tasogarenokagi/featherlight/README.md

LED medallion with 9-DOF motion sensing.
