tasogarenokagi/featherlight/featherlight.kicad_pcb

## KiCad design featherlight.kicad_pcb (2017-03-16)

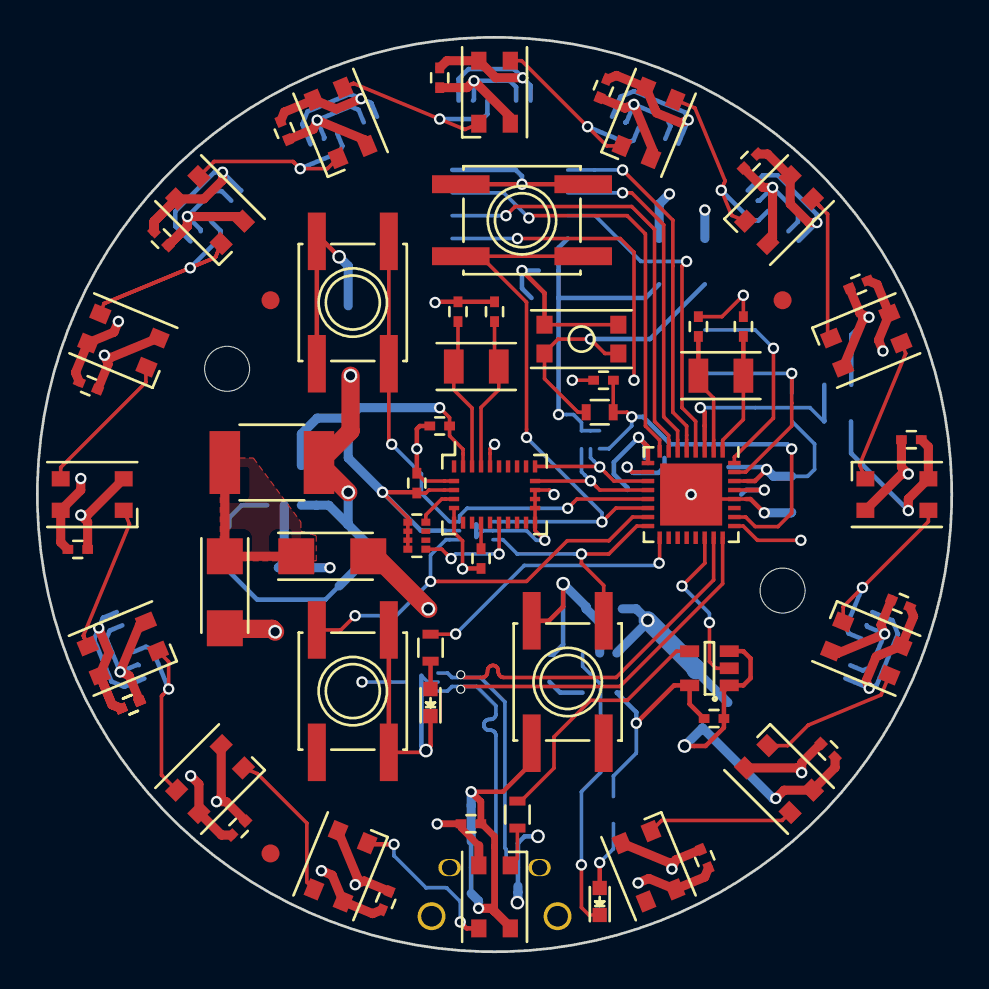
[picture p1: board featherlight.kicad_pcb from above]

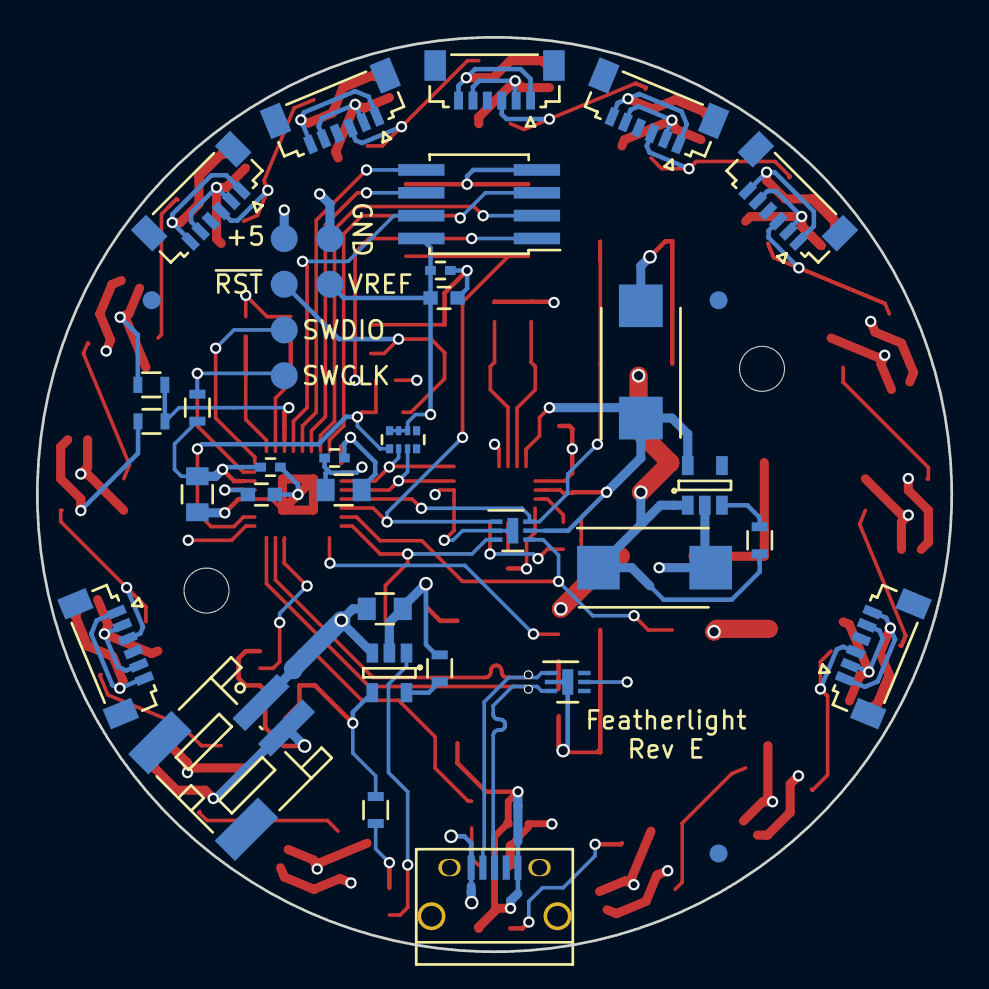
[picture p2: board featherlight.kicad_pcb from below]

Board: 4 copper layers, 50.8 x 50.8 mm, 106 parts (40 on the bottom side), 57 nets.

Parts:
C1, C2, C10, C11: 22 pF; C_0402
C3, C4, C7, C8, C9, C12, C13, C15, C16, C17, C18, C19, C20, C21, C22, C22#2, C23, C24, C25, C26, C27, C28, C29, C30, C35: 0.1 uF; C_0402
C5, C6, C33: 10 uF; C_0805
C14, C34: 1 uF; C_0603
C31, C32: 220 uF; TantalC_SizeD_EIA-7343_Reflow
D1, D2, D3, D4, D5, D6, D7, D8, D9, D10, D11, D12, D13, D14, D15, D16: SK6812MINI; LED_SK6812MINI-PLCC4
D19, D23: DRTR5V0U4LP16; DFN-6-1EP_2x2mm_Pitch0.5mm
D20, D24: MBRA210LT3G; DO-214AC
D21: Green; LED_0603
D22: Red; LED_0603
F1: FUSE; 1812_PTC
FID1, FID2, FID3, FID4, FID5, FID6: Fiducial; Fiducial_1mm_Dia_2.54mm_Outer_CopperTop
HOLE1, HOLE2: Fiducial; MountingHole_2.5mm
P1: USB_OTG; USB_Micro-B
P2: CONN_01X02; JST_PH_S2B-PH-SM4-TB_02x2.00mm_Angled
P3, P4, P5, P6, P7, P8: CONN_01X01; Measurement_Point_Round-SMD-Pad_Small
P11, P12, P13, P14, P15, P16, P17: CONN_01X06; JST_SUR_SM06B-SURS-TF_06x0.80mm_Angled
R2, R7, R12: 470; R_0603
R3, R4: 1 K; R_0603
R10, R11, R13: 100 K; R_0603
R14: 10 K; R_0603
RN1, RN2: 10 K; R_Array_Convex_4x0402
SW1: Button; KMR2_switch
SW2, SW3, SW4, SW5: Button; SW_SPST_EVQQ2
U1: BNO055; LGA-28
U2: SAMD21E18A-M; QFN-32-1EP_5x5mm_Pitch0.5mm
U3: 74AHCT1G125; SOT-23-5
U4: AP2112; SOT-23-5
U5: MCP73831; SOT-23-5
U6: 16 Mb SPI Flash; SOIC-8_Universal_Pitch1.27mm
Y1, Y2: 32.768 KHz; Crystal_SMD_3215_2Pads

Connections:
+3V3: C3.1, C4.2, C5.1, C6.2, C7.1, C8.2, C32.1, C34.1, C35.1, D23.5, P8.1, R4.1, RN1.6, RN1.7, RN1.8, RN2.1, RN2.2, RN2.3, RN2.4, U1.3, U1.28, U2.9, U2.30, U4.5, U6.8
+BATT: C33.2, D20.2, P2.1, U5.3
/LED Array/D1D0: D1.1, D2.3
/LED Array/D2DO: D2.1, D3.3
/LED Array/D3DO: D3.1, D4.3, P11.3
/LED Array/D4DO: D4.1, D5.3
/LED Array/D5DO: D5.1, D6.3
/LED Array/D6DO: D6.1, D7.3, P12.3
/LED Array/D7DO: D7.1, D8.3, P13.3
/LED Array/D8DO: D8.1, D9.3, P14.3
/LED Array/D9DO: D9.1, D10.3, P15.3
/LED Array/D10DO: D10.1, D11.3, P16.3
/LED Array/D11DO: D11.1, D12.3
/LED Array/D13DO: D13.1, D14.3, P17.3
/LED Array/D14DO: D14.1, D15.3
/LED Array/D15DO: D15.1, D16.3
/MCU + IMU/ATMEL_RESET: C9.1, R2.1, RN1.1, U2.26
/MCU + IMU/BNO_BOOTLOAD: RN2.8, U1.4
/MCU + IMU/BNO_RESET: RN2.5, U1.11
/MCU + IMU/LV_LED_control_stream: U2.22, U3.2
/MCU + IMU/MISO: U2.7, U6.2
/MCU + IMU/MOSI: U2.5, U6.5
/MCU + IMU/SCL: RN1.3, U1.19, U2.12
/MCU + IMU/SCLK: U2.6, U6.6
/MCU + IMU/SDA: RN1.2, U1.20, U2.11
/MCU + IMU/~CS~: U2.25, U6.1
/MCU + IMU/~HOLD~: U2.4, U6.7
/MCU + IMU/~WP~: U2.8, U6.3
/Power Regulation & Distribution/VFUSE: D20.1, D24.1, F1.1
/Power Regulation & Distribution/VUSB: D19.5, D24.2, P1.1
D+: D19.3, P1.3, U2.24
D-: D19.1, P1.2, U2.23
GND: C1.1, C2.1, C3.2, C4.1, C5.2, C6.1, C7.2, C8.1, C9.2, C10.1, C11.1, C12.2, C13.2, C14.2, C15.2, C16.2, C17.2, C18.2, C19.2, C20.2, C21.2, C22.2, C22#2.2, C23.2, C24.2, C25.2, C26.2, C27.2, C28.2, C29.2, C30.2, C31.2, C32.2, C33.1, C34.2, C35.2, D1.2, D2.2, D3.2, D4.2, D5.2, D6.2, D7.2, D8.2, D9.2, D10.2, D11.2, D12.2, D13.2, D14.2, D15.2, D16.2, D19.2, D19.7, D22.1, D23.2, D23.7, P1.5, P1.6, P2.2, P7.1, P11.1, P11.6, P12.1, P12.6, P13.1, P13.6, P14.1, P14.6, P15.1, P15.6, P16.1, P16.6, P17.1, P17.6, R13.1, R14.2, SW1.1, SW2.1, SW3.1, SW4.1, SW5.1, U1.2, U1.5, U1.6, U1.15, U1.16, U1.17, U1.18, U1.25, U2.10, U2.28, U2.33, U3.1, U3.3, U4.2, U5.2, U6.4
LED_control_stream: R7.2, U3.4
LL_BUTTON: D23.4, SW4.2, U2.15
LR_BUTTON: D23.3, SW5.2, U2.16
unnamed: C1.2, U2.1, Y1.1
unnamed: C2.2, U2.2, Y1.2
unnamed: C10.2, U1.26, Y2.1
unnamed: C11.2, U1.27, Y2.2
unnamed: C12.1, U1.9
unnamed: C14.1, U2.29
unnamed: D1.3, R7.1
unnamed: D12.1, D13.3
unnamed: D21.1, U5.1
unnamed: D21.2, R12.2
unnamed: D22.2, R3.1
unnamed: R3.2, U2.17
unnamed: R10.1, U4.3
unnamed: R14.1, U5.5
SWCLK: P3.1, R4.2, U2.31
SWDIO: P4.1, U2.32
UL_BUTTON: D23.6, SW2.2, U2.13
UR_BUTTON: D23.1, SW3.2, U2.14
VDD: C13.1, C15.1, C16.1, C17.1, C18.1, C19.1, C20.1, C21.1, C22.1, C22#2.1, C23.1, C24.1, C25.1, C26.1, C27.1, C28.1, C29.1, C30.1, C31.1, D1.4, D2.4, D3.4, D4.4, D5.4, D6.4, D7.4, D8.4, D9.4, D10.4, D11.4, D12.4, D13.4, D14.4, D15.4, D16.4, F1.2, P6.1, P11.2, P11.5, P12.2, P12.5, P13.2, P13.5, P14.2, P14.5, P15.2, P15.5, P16.2, P16.5, P17.2, P17.5, R10.2, R11.2, R12.1, U3.5, U4.1, U5.4
VDD_MON: R11.1, R13.2, U2.3
~RST~: P5.1, R2.2, SW1.2
