tasogarenokagi/featherlight/(commit log)

2016-08-26 initial file import
    [featherlight.kicad_pcb, featherlight.sch, featherlight_mcu.sch, leds.sch, power.sch]
2016-08-30 Added part BOM metadata.
    [featherlight.kicad_pcb, featherlight_mcu.sch, leds.sch, power.sch]
2016-09-02 Component changes to reduce BOM cost.
    -Swap SAMD21 package to 48-QFN.
    -Swap Tantalum power caps for Aluminum Polymer.
    [featherlight.kicad_pcb, featherlight_mcu.sch, power.sch]
2016-09-04 Prepare for github export.
    -Added README.md
    -Added LICENSE.md
    -Exported footprints.
2016-09-08 Further development work while waiting for the first prototypes to come back.
    -Moved to 4 layer board because the power routing got to be too much of a headache.
    -Run all power through a PTC fuse.
    -Added a voltage divider to allow the MCU to monitor bus voltage.
    -Added JST-2 connector and battery circuitry to permit powering from lipo cells. Feeds VDD via a diode to avoid bad things happening. Intended to work with Adafruit's packs.
    -Added 4 push buttons to form a user interface.
    -Removed external pull up resistor on reset line. MCU has internal pull ups.
    [featherlight.kicad_pcb, featherlight_mcu.sch, leds.sch, power.sch]
2016-09-08 Propagate component MSL data back from BOM spreadsheet.
    [featherlight_mcu.sch, leds.sch, power.sch]
2016-09-08 Tweaked trace routing to remove several vias.
    Expanded the copper pour connecting 3.3V regulator to power plane.
    Removed placeholder MDBT40 footprint. I want to see if the buttons are enough of a UI that bluetooth is no longer necessary.
    [featherlight.kicad_pcb]
2016-09-09 Changed PTH on the USB footprint to circular drills since Oshpark cannot into slots.
    [featherlight.kicad_pcb, power.sch]
2016-09-11 Improper board size required full PCB redesign.
    The rev A PCBs were far bigger than intended (target diameter was used as radius when laying it out).
    Removed lipo circuit while reworking layout; will try to add it back in later.
    Moved USB port to very edge of board to permit cable access.
    Added +5V and ground contacts to ISP pads.
    Swapped down to SAMD21E MCU for space reasons.
    Removed connectors for space reasons. Maybe they'll fit on the bottom?
    Added fiducials front and back.
    [featherlight.kicad_pcb, featherlight.sch, featherlight_mcu.sch, leds.sch, power.sch]
2016-09-11 Linked appropriate or placeholder 3D models to custom footprints.
2016-09-11 Re-added lipo circuit.
    [featherlight.kicad_pcb, featherlight_mcu.sch, power.sch]
2016-09-11 Trying out a 2 inch diameter disk.
    [featherlight.kicad_pcb]
2016-09-12 Added MCU reset to SWD pads.
    [featherlight.kicad_pcb, featherlight_mcu.sch, power.sch]
2016-09-13 I have greatly misunderstood the function of VDDCore on the MCU. orz.
    Added additional bypass caps for the MCU and changed the battery bypass cap for BOM commonality.
    [featherlight.kicad_pcb, featherlight_mcu.sch, leds.sch, power.sch]
2016-09-13 Reenumerated all components.
    [featherlight.kicad_pcb, featherlight.sch, featherlight_mcu.sch, leds.sch, power.sch]
2016-09-14 Added mounting holes and two candidates for fingerlight connectors.
    [featherlight.kicad_pcb, featherlight_mcu.sch, leds.sch, power.sch]
2016-09-15 Swapped UI buttons to EVQQ2 and rearranged board to fit.
    [featherlight.kicad_pcb, featherlight_mcu.sch]
2016-09-15 Always run DRC before commiting.
    [featherlight.kicad_pcb]
2016-09-16 Dimensioned PCB and location of mounting holes.
    [featherlight.kicad_pcb]
2016-09-16 Redid dimensioning after trying to create a mechanical model.
    [featherlight.kicad_pcb]
2016-09-18 cleaned up VUSB trace on the back layer.
    [featherlight.kicad_pcb]
2016-09-19 Swapped BOM fields on UI buttons to Panasonic EVQQ2 switches.
    [featherlight_mcu.sch]
2016-09-19 Moved 2nd resistor in VDD voltage divider to top layer because I can and it deletes a via.
    [featherlight.kicad_pcb]
2016-09-27 Added USB plated through holes to paste layers.
    [featherlight.kicad_pcb]
2016-10-06 Rerouted serpentine ground trace on neopixel #1
    [featherlight.kicad_pcb]
2016-10-06 Bumped revision to rev C.
    [featherlight.kicad_pcb]
2016-10-09 10000 pF is not 0.1 uF. Fixed all the screwed up caps.
    [featherlight.sch, featherlight_mcu.sch, leds.sch]
2016-11-25 Remove uneeded track found during gerber review.
    [featherlight.kicad_pcb]
2016-11-25 Adjusted micro USB footprint so the PTH are not on the front paste layer.
    [featherlight.kicad_pcb]
2016-11-26 Reduced solder paste ratio to try and address solder bridging issues.
    [featherlight.kicad_pcb]
2016-11-27 Critical failure: EP on SAMD21 is tied to ground. orz.
    [featherlight.kicad_pcb, featherlight.sch, featherlight_mcu.sch, leds.sch, power.sch]
2016-11-27 Addressed several todo items while working towards rev C tape out.
    *Tweaked fill zone settings.
    *Tweaked design rules to permit use of a faster PCB house.
    *Removed FFC connectors since they were found wanting vs the JST SUR connectors.
    *Replaced cluster of 10 K resistors with a packed array.
    [featherlight.kicad_pcb, featherlight_mcu.sch, leds.sch, power.sch]
2016-11-28 Addressed several todo items while working towards rev C tape out.
    *Added additional fingerlight connectors to make the design ambidextrous.
    *Moved programming pads and added a 3.3V Vref pad.
    *Added a SPI flash chip because micropython might be cool.
    *Added ESD protection to the UI buttons and adjusted schematic to allow use of a different component.
    *Added isolation diode on Vusb, and moved Vusb trace to internal layer.
    [featherlight.kicad_pcb, featherlight_mcu.sch, leds.sch, power.sch]
2016-11-28 Trace cleanup noticed while reviewing gerbers.
    [featherlight.kicad_pcb]
2016-12-10 Somehow I deleted the mounting holes while working on rev C.
    Had to move UL button and VDD power LED to add them back in at a new position.
    [featherlight.kicad_pcb]
2016-12-10 Bumped to rev D.
    [featherlight.kicad_pcb]
2016-12-11 Added stencil supports to Eco layers and re-dimensioned the mounting holes.
    [featherlight.kicad_pcb]
2016-12-18 Rescaled power diode 3D models, and adjusted support pillar after jig fabrication issues.
    [featherlight.kicad_pcb]
2016-12-23 Adjusted support pillar after jig fabrication issues.
    [featherlight.kicad_pcb]
2017-01-03 Removed trace bodge on USB ESD protection. A solder bridge will work for the few remaining components.
    [featherlight.kicad_pcb, power.sch]
2017-01-03 Deleted power rail LEDs.
    [featherlight.kicad_pcb, power.sch]
2017-01-03 Discovered why the mounting holes keep disappearing, so they're on the schematic now.
    [featherlight.kicad_pcb, featherlight.sch]
2017-01-03 Replaced SOIC-8 footprint with one that can accomodate both 3.9mm and 5.3mm component widths.
    [featherlight.kicad_pcb, featherlight_mcu.sch, power.sch]
2017-01-03 Holes are not fiducials (but their schematic graphic is useful.
    [featherlight.sch]
2017-01-04 Regenerated fill zones.
    [featherlight.kicad_pcb]
2017-01-04 Deleted central pillars on Eco1.User support layer.
    [featherlight.kicad_pcb]
2017-01-04 Moved enable resistor on regulator to avoid support pillar.
    [featherlight.kicad_pcb]
2017-01-04 Moved programming header label due to resized 8-SOIC footprint.
    [featherlight.kicad_pcb]
2017-01-04 Changed silkscreen of 220 uF cap to better highlight pin 1 polarity.
    [featherlight.kicad_pcb, power.sch]
2017-01-11 Changed pad and mask geometry of BNO055 footprint based on manufacturer guidelines (ref. Handling, soldering & mounting instructions for BNO055).
    [featherlight.kicad_pcb, featherlight_mcu.sch]
2017-01-11 Extensive revisions of PCB connecting and near the BNO055 after issues with rev C and finding relevant design notes.
    -Top copper layer below the sensor is now a keep out zone. This required extensive trace rerouting due to all the pins tied to ground.
    -Added pullups to the bootloader and reset pins (they were previously floating). Expect this was the main reason I could never get it to initialize.
    -Added pulldown to I2C address selection pin (it was previously directly connected). It's what Adafruit does and I had an extra lane in the nearby resistor pack.
    [featherlight.kicad_pcb, featherlight_mcu.sch]
2017-01-11 Moved USB port inwards slightly after noticing damage to the outer PTH on rev C boards.
    [featherlight.kicad_pcb]
2017-01-12 Grounded USB shield after issues with programming MCU over USB.
    The Atmel design notes recommend grounding through an RC filter, but Adafruit ignores it, and that's good enough for me.
    [featherlight.kicad_pcb, power.sch]
2017-01-12 Rotated the power diodes and fuse since the spiralling traces bothered me.
    [featherlight.kicad_pcb]
2017-01-12 Bumped mounting holes up to M2.5 (Adafruit again).
    [featherlight.kicad_pcb, featherlight.sch]
2017-01-23 Propagated all jig changes to the Eco* layers.
    [featherlight.kicad_pcb]
2017-01-23 Fixed component 3d models after a kicad update.
    [featherlight.kicad_pcb]
2017-01-24 Put MCU analog ground and VDD on dedicated vias after reading a bit about analog PCB design.
    http://www.edn.com/design/pc-board/4443239/Properly-ground-your-circuits
    [featherlight.kicad_pcb]
2017-01-24 Rev E
    [featherlight.kicad_pcb]
2017-01-26 Changed pin types on the TVS array after studying up Electronic Rules Checking.
2017-01-26 Moved via to the side of the internal power trace.
    [featherlight.kicad_pcb]
2017-01-26 Reduced global solder mask pullback to 0.05 mm to address solder briding issues on some of the components.
    [featherlight.kicad_pcb]
2017-01-26 Standardized on 8 mil width for all non-power MCU traces.
    [featherlight.kicad_pcb]
2017-01-26 Added part number and manufacturer to SPI flash component.
    [featherlight_mcu.sch]
2017-01-26 Ran the numbers so USB differential traces are 8 mil wide and spaced 0.5 mm on center.
    [featherlight.kicad_pcb]
2017-01-27 Replaced as many thin vias as I could.
    The remainders are the USB data traces and the critial area between MCU and IMU.
    [featherlight.kicad_pcb]
2017-01-31 All 0402 components (0.1 uF or 22 pF capacitors) fixed to -5% paste coverage.
    [featherlight.kicad_pcb]
2017-01-31 Added fake dowel pad with tuned paste layer parameters.
    Represents the alignment dowel pins when generating stencil gerbers for external fabrication.
2017-02-01 Moved USB port outwards slightly after issues populating it.
    Split the difference between Rev C and Rev D.
    [featherlight.kicad_pcb]
2017-03-16 Changed BNO055 I2C address selection from a pull down to a direct ground tie in the hope it will fix the address instability.
    [featherlight.kicad_pcb, featherlight_mcu.sch, leds.sch, power.sch]
2017-07-07 Updated USB port schematic symbol after kicad update.
    [power.sch]
2018-02-08 Updated schematics to EESchema version 4 file format.
    [featherlight.sch, featherlight_mcu.sch, leds.sch, power.sch]
